jawsper/dmgcart/README.md

# dmgcart
DMGcart: STM32F429 based Game Boy flashcart

These are the hardware design files for the DMGcart.

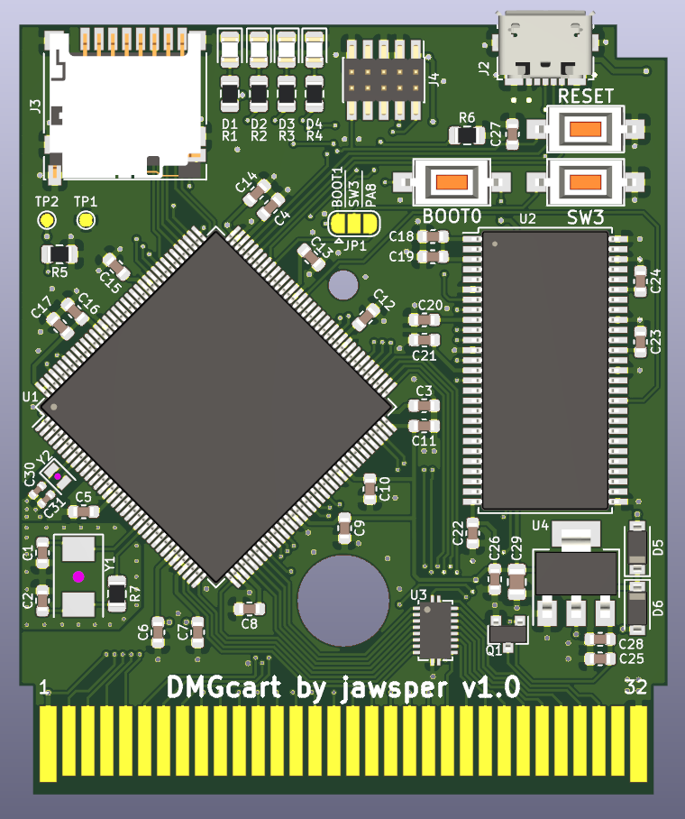
[picture p1: renders/dmgcart-front.png]
Board front


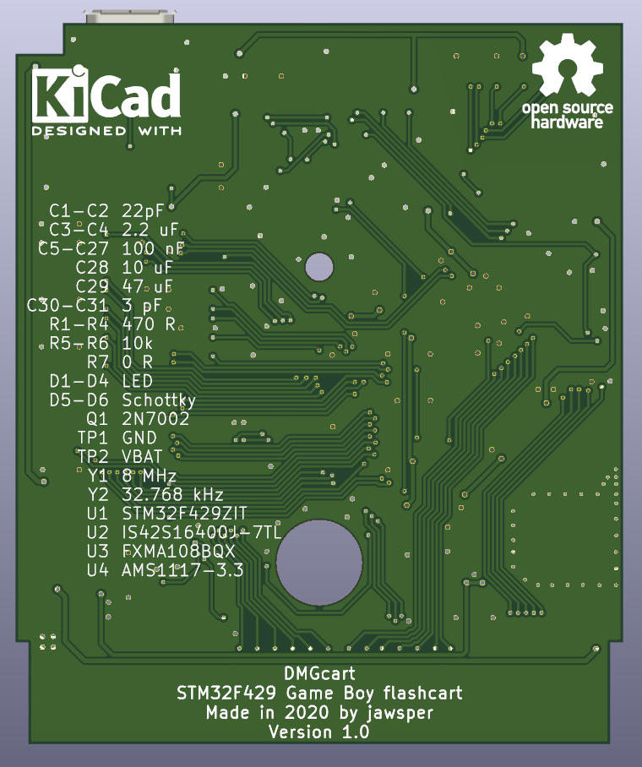
[picture p2: renders/dmgcart-rear.png]
Board read
