jawsper/dmgcart/dmgcart.kicad_pcb

## KiCad design dmgcart.kicad_pcb (2020-03-15)

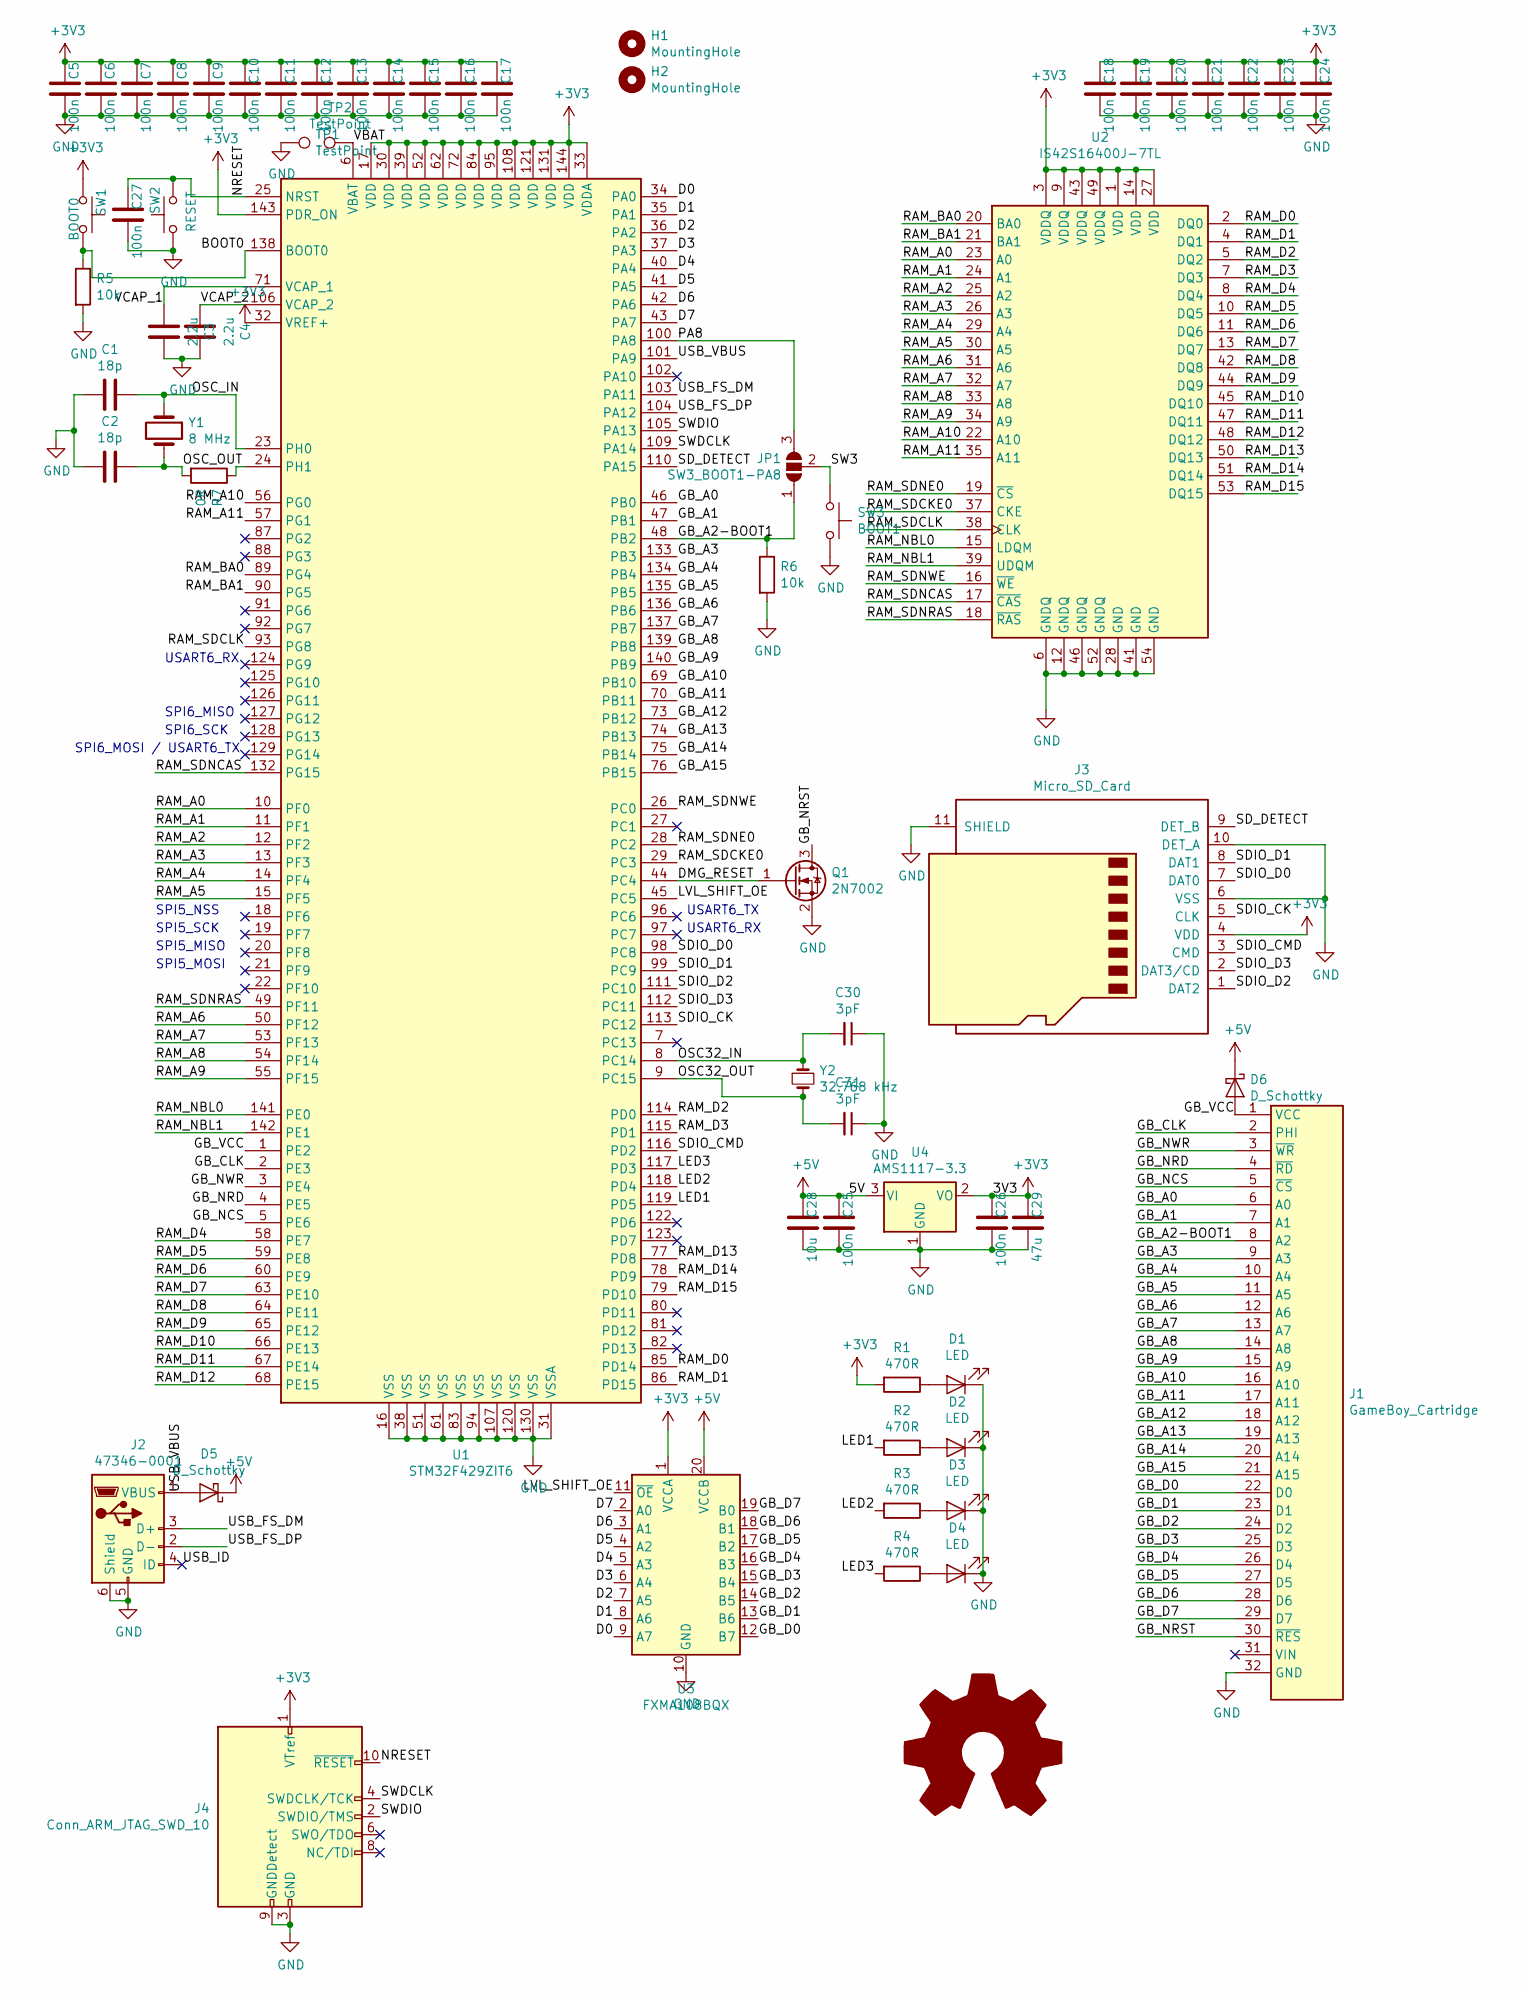
[picture p3: schematic dmgcart.sch]

Parts:
C1, C2: 18p; C_0603_1608Metric; Mouser 80-C0603C180K5RACTU
C3, C4: 2.2u; C_0603_1608Metric; Mouser 963-UMK107BBJ225KA-T
C5, C6, C7, C8, C9, C10, C11, C12, C13, C14, C15, C16, C17, C18, C19, C20, C21, C22, C23, C24, C25, C26, C27: 100n; C_0603_1608Metric; Mouser 80-C0603C104K5REC
C28: 10u; C_0603_1608Metric
C29: 47u; C_0805_2012Metric
C30, C31: 3pF; C_0402_1005Metric
D1, D2, D3, D4: LED; LED_0805_2012Metric
D5, D6: D_Schottky; D_SOD-123
H1: MountingHole; MountingHole_7.2mm
H2: MountingHole; MountingHole_2.3mm
J1: GameBoy_Cartridge; GameBoy_Cartridge_1x32_P1.50mm_Edge
J2: 47346-0001; USB_Micro-B_Molex_47346-0001; Mouser 538-47346-0001
J3: Micro_SD_Card; microSD_HC_Hirose_DM3D-SF; Mouser 798-DM3D-SF
J4: Conn_ARM_JTAG_SWD_10; PinHeader_2x05_P1.27mm_Vertical_SMD
JP1: SW3_BOOT1-PA8; SolderJumper-3_P1.3mm_Open_RoundedPad1.0x1.5mm
Q1: 2N7002; SOT-23
R1, R2, R3, R4: 470R; R_0805_2012Metric
R5, R6: 10k; R_0805_2012Metric
R7: 0R; R_0805_2012Metric
SW1: BOOT0; SW_SPST_CK_RS282G05A3
SW2: RESET; SW_SPST_CK_RS282G05A3
SW3: BOOT1; SW_SPST_CK_RS282G05A3
TP1, TP2: TestPoint; TestPoint_Pad_D1.0mm
U1: STM32F429ZIT6; LQFP-144_20x20mm_P0.5mm; Mouser 511-STM32F429ZIT6
U2: IS42S16400J-7TL; TSOP-II-54_22.2x10.16mm_P0.8mm; Mouser 870-IS42S16400J-7TL
U3: FXMA108BQX; WQFN-20-1EP_2.5x4.5mm_P0.5mm_EP1x2.9mm; Mouser 512-FXMA108BQX
U4: AMS1117-3.3; SOT-223-3_TabPin2
Y1: 8 MHz; Crystal_SMD_0603-2Pin_6.0x3.5mm; Mouser 520-8.0-18-23G-JGNT
Y2: 32.768 kHz; Crystal_SMD_2012-2Pin_2.0x1.2mm; Mouser 815-ABS06W32.768KD2T

Connections:
+3V3: C5.2, C6.2, C7.2, C8.2, C9.2, C10.2, C11.2, C12.2, C13.2, C14.2, C15.2, C16.2, C17.2, C18.2, C19.2, C20.2, C21.2, C22.2, C23.2, C24.2, C26.2, C29.2, J3.4 (VDD), J4.1 (VTref), R1.2, SW1.1, U1.17 (VDD), U1.30 (VDD), U1.32 (VREF+), U1.33 (VDDA), U1.39 (VDD), U1.52 (VDD), U1.62 (VDD), U1.72 (VDD), U1.84 (VDD), U1.95 (VDD), U1.108 (VDD), U1.121 (VDD), U1.131 (VDD), U1.143 (PDR_ON), U1.144 (VDD), U2.1 (VDD), U2.3 (VDDQ), U2.9 (VDDQ), U2.14 (VDD), U2.27 (VDD), U2.43 (VDDQ), U2.49 (VDDQ), U3.1 (VCCA), U4.2 (VO)
+5V: C25.2, C28.2, D5.1 (K), D6.1 (K), U3.20 (VCCB), U4.3 (VI)
/BOOT0: R5.1, SW1.2, U1.138 (BOOT0)
/D0: U1.34 (PA0), U3.9 (A7)
/D1: U1.35 (PA1), U3.8 (A6)
/D2: U1.36 (PA2), U3.7 (A5)
/D3: U1.37 (PA3), U3.6 (A4)
/D4: U1.40 (PA4), U3.5 (A3)
/D5: U1.41 (PA5), U3.4 (A2)
/D6: U1.42 (PA6), U3.3 (A1)
/D7: U1.43 (PA7), U3.2 (A0)
/DMG_RESET: Q1.1 (G), U1.44 (PC4)
/GB_A0: J1.6 (A0), U1.46 (PB0)
/GB_A1: J1.7 (A1), U1.47 (PB1)
/GB_A2-BOOT1: J1.8 (A2), JP1.1 (A), R6.1, U1.48 (PB2)
/GB_A3: J1.9 (A3), U1.133 (PB3)
/GB_A4: J1.10 (A4), U1.134 (PB4)
/GB_A5: J1.11 (A5), U1.135 (PB5)
/GB_A6: J1.12 (A6), U1.136 (PB6)
/GB_A7: J1.13 (A7), U1.137 (PB7)
/GB_A8: J1.14 (A8), U1.139 (PB8)
/GB_A9: J1.15 (A9), U1.140 (PB9)
/GB_A10: J1.16 (A10), U1.69 (PB10)
/GB_A11: J1.17 (A11), U1.70 (PB11)
/GB_A12: J1.18 (A12), U1.73 (PB12)
/GB_A13: J1.19 (A13), U1.74 (PB13)
/GB_A14: J1.20 (A14), U1.75 (PB14)
/GB_A15: J1.21 (A15), U1.76 (PB15)
/GB_CLK: J1.2 (PHI), U1.2 (PE3)
/GB_D0: J1.22 (D0), U3.12 (B7)
/GB_D1: J1.23 (D1), U3.13 (B6)
/GB_D2: J1.24 (D2), U3.14 (B5)
/GB_D3: J1.25 (D3), U3.15 (B4)
/GB_D4: J1.26 (D4), U3.16 (B3)
/GB_D5: J1.27 (D5), U3.17 (B2)
/GB_D6: J1.28 (D6), U3.18 (B1)
/GB_D7: J1.29 (D7), U3.19 (B0)
/GB_NCS: J1.5 (~CS), U1.5 (PE6)
/GB_NRD: J1.4 (~RD), U1.4 (PE5)
/GB_NRST: J1.30 (~RES), Q1.3 (D)
/GB_NWR: J1.3 (~WR), U1.3 (PE4)
/GB_VCC: D6.2 (A), J1.1 (VCC), U1.1 (PE2)
/LED1: R2.2, U1.119 (PD5)
/LED2: R3.2, U1.118 (PD4)
/LED3: R4.2, U1.117 (PD3)
/LVL_SHIFT_OE: U1.45 (PC5), U3.11 (~OE)
/NRESET: C27.2, J4.10 (~RESET~), SW2.2, U1.25 (NRST)
/OSC32_IN: C30.2, U1.8 (PC14), Y2.1
/OSC32_OUT: C31.2, U1.9 (PC15), Y2.2
/OSC_IN: C1.1, U1.23 (PH0), Y1.1
/OSC_OUT: C2.1, R7.2, Y1.2
/PA8: JP1.3 (B), U1.100 (PA8)
/RAM_A0: U1.10 (PF0), U2.23 (A0)
/RAM_A1: U1.11 (PF1), U2.24 (A1)
/RAM_A2: U1.12 (PF2), U2.25 (A2)
/RAM_A3: U1.13 (PF3), U2.26 (A3)
/RAM_A4: U1.14 (PF4), U2.29 (A4)
/RAM_A5: U1.15 (PF5), U2.30 (A5)
/RAM_A6: U1.50 (PF12), U2.31 (A6)
/RAM_A7: U1.53 (PF13), U2.32 (A7)
/RAM_A8: U1.54 (PF14), U2.33 (A8)
/RAM_A9: U1.55 (PF15), U2.34 (A9)
/RAM_A10: U1.56 (PG0), U2.22 (A10)
/RAM_A11: U1.57 (PG1), U2.35 (A11)
/RAM_BA0: U1.89 (PG4), U2.20 (BA0)
/RAM_BA1: U1.90 (PG5), U2.21 (BA1)
/RAM_D0: U1.85 (PD14), U2.2 (DQ0)
/RAM_D1: U1.86 (PD15), U2.4 (DQ1)
/RAM_D2: U1.114 (PD0), U2.5 (DQ2)
/RAM_D3: U1.115 (PD1), U2.7 (DQ3)
/RAM_D4: U1.58 (PE7), U2.8 (DQ4)
/RAM_D5: U1.59 (PE8), U2.10 (DQ5)
/RAM_D6: U1.60 (PE9), U2.11 (DQ6)
/RAM_D7: U1.63 (PE10), U2.13 (DQ7)
/RAM_D8: U1.64 (PE11), U2.42 (DQ8)
/RAM_D9: U1.65 (PE12), U2.44 (DQ9)
/RAM_D10: U1.66 (PE13), U2.45 (DQ10)
/RAM_D11: U1.67 (PE14), U2.47 (DQ11)
/RAM_D12: U1.68 (PE15), U2.48 (DQ12)
/RAM_D13: U1.77 (PD8), U2.50 (DQ13)
/RAM_D14: U1.78 (PD9), U2.51 (DQ14)
/RAM_D15: U1.79 (PD10), U2.53 (DQ15)
/RAM_NBL0: U1.141 (PE0), U2.15 (LDQM)
/RAM_NBL1: U1.142 (PE1), U2.39 (UDQM)
/RAM_SDCKE0: U1.29 (PC3), U2.37 (CKE)
/RAM_SDCLK: U1.93 (PG8), U2.38 (CLK)
/RAM_SDNCAS: U1.132 (PG15), U2.17 (~CAS)
/RAM_SDNE0: U1.28 (PC2), U2.19 (~CS)
/RAM_SDNRAS: U1.49 (PF11), U2.18 (~RAS)
/RAM_SDNWE: U1.26 (PC0), U2.16 (~WE)
/SDIO_CK: J3.5 (CLK), U1.113 (PC12)
/SDIO_CMD: J3.3 (CMD), U1.116 (PD2)
/SDIO_D0: J3.7 (DAT0), U1.98 (PC8)
/SDIO_D1: J3.8 (DAT1), U1.99 (PC9)
/SDIO_D2: J3.1 (DAT2), U1.111 (PC10)
/SDIO_D3: J3.2 (DAT3/CD), U1.112 (PC11)
/SD_DETECT: J3.9 (DET_B), U1.110 (PA15)
/SW3: JP1.2 (C), SW3.1
/SWDCLK: J4.4 (SWDCLK/TCK), U1.109 (PA14)
/SWDIO: J4.2 (SWDIO/TMS), U1.105 (PA13)
/USB_FS_DM: J2.3 (D+), U1.103 (PA11)
/USB_FS_DP: J2.2 (D-), U1.104 (PA12)
/USB_ID: J2.4 (ID)
/USB_VBUS: D5.2 (A), J2.1 (VBUS), U1.101 (PA9)
/VBAT: TP2.1, U1.6 (VBAT)
/VCAP_1: C3.2, U1.71 (VCAP_1)
/VCAP_2: C4.2, U1.106 (VCAP_2)
GND: C1.2, C2.2, C3.1, C4.1, C5.1, C6.1, C7.1, C8.1, C9.1, C10.1, C11.1, C12.1, C13.1, C14.1, C15.1, C16.1, C17.1, C18.1, C19.1, C20.1, C21.1, C22.1, C23.1, C24.1, C25.1, C26.1, C27.1, C28.1, C29.1, C30.1, C31.1, D1.1 (K), D2.1 (K), D3.1 (K), D4.1 (K), J1.32 (GND), J2.5 (GND), J2.6 (Shield), J3.6 (VSS), J3.10 (DET_A), J3.11 (SHIELD), J4.3 (GND), J4.5 (GND), J4.9 (GNDDetect), Q1.2 (S), R5.2, R6.2, SW2.1, SW3.2, TP1.1, U1.16 (VSS), U1.31 (VSSA), U1.38 (VSS), U1.51 (VSS), U1.61 (VSS), U1.83 (VSS), U1.94 (VSS), U1.107 (VSS), U1.120 (VSS), U1.130 (VSS), U2.6 (GNDQ), U2.12 (GNDQ), U2.28 (GND), U2.41 (GND), U2.46 (GNDQ), U2.52 (GNDQ), U2.54 (GND), U3.10 (GND), U4.1 (GND)
unnamed: D1.2 (A), R1.1
unnamed: D2.2 (A), R2.1
unnamed: D3.2 (A), R3.1
unnamed: D4.2 (A), R4.1
unnamed: R7.1, U1.24 (PH1)

Notes on the sheet:
SPI5_NSS
SPI5_SCK
SPI5_MISO
SPI5_MOSI
USART6_RX
SPI6_MISO
SPI6_SCK
SPI6_MOSI / USART6_TX
USART6_TX

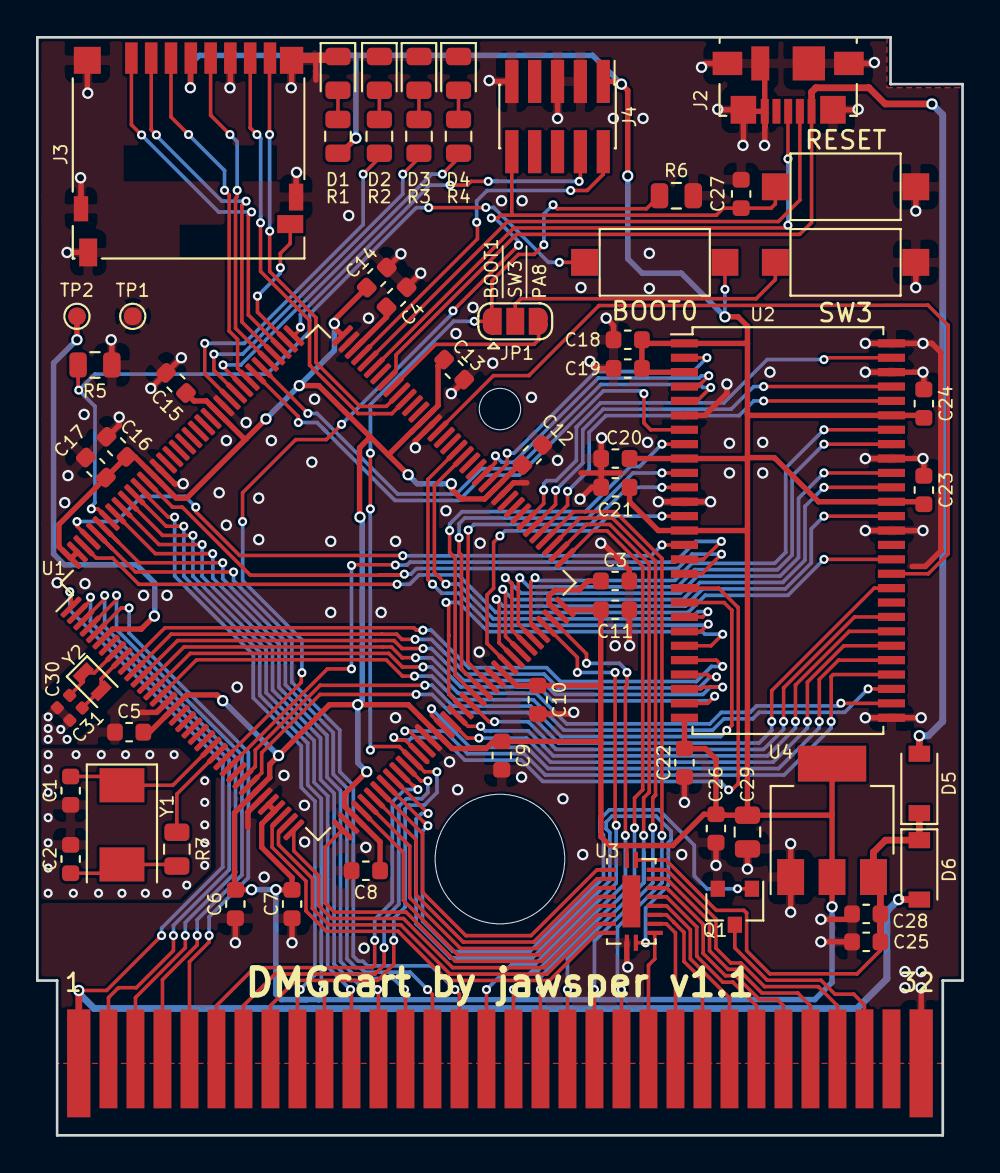
[picture p4: board dmgcart.kicad_pcb from above]

Board: 2 copper layers, 51.4 x 61.0 mm, 63 parts (0 on the bottom side), 112 nets.
