jawsper/dmgcart/(threads)

Thread 1 (2020-03-15):

OE line of level translator tied to wrong level

jawsper, 2020-03-15:
The OE line (11) of U3 is tied to VCC which disables the chip.
It should be tied to either GND or a GPIO instead.

Closed 2020-03-15.
