jawsper/dmgcart/(commit log)

2020-03-06 Initial commit
    Added hardware design files.
    Added external lib with Game Boy footprints.
    [dmgcart.kicad_pcb, dmgcart.sch]
2020-03-09 Updated design files
    * Moved components up so they shouldn't collide with the case.
    * Rereferenced components so they are sorted by value.
    * Added pad for 32k RTC oscillator.
    * Several small tweaks to routing.
    * Added component value list to back silkscreen.
    * Added board renders
    [dmgcart.kicad_pcb, dmgcart.sch]
2020-03-10 Added interactive BOM.
    Also added Mouser part no. for the specific 32k xtal that would work.
    [dmgcart.sch]
2020-03-15 Fix #1: Tie /OE of U3 to PC5 instead of VCC.
    This was an error, tying /OE to VCC actually disables the outputs
    of U3. By tying it to a GPIO, it can be controlled by the MCU instead.
    Additional changes:
    * Some small tweaks on the PCB settings in KiCad (board thickness etc)
    * Updated HTML BOM.
    * Changed revision to v1.1
    [dmgcart.kicad_pcb, dmgcart.sch]
